Animus-Surge/stardragon-l3/README.md

# Stardragon

Stardragon is a tripoli L3 certification rocket based on an ultimate wildman rocket kit.

## Overview

## Quarto reports

Under `proposal_files` and `report_files`, there are the various reports that were generated for the proposal and final report.

## CAD files

## Simulations
