Animus-Surge/stardragon-l3/mission_patch.png

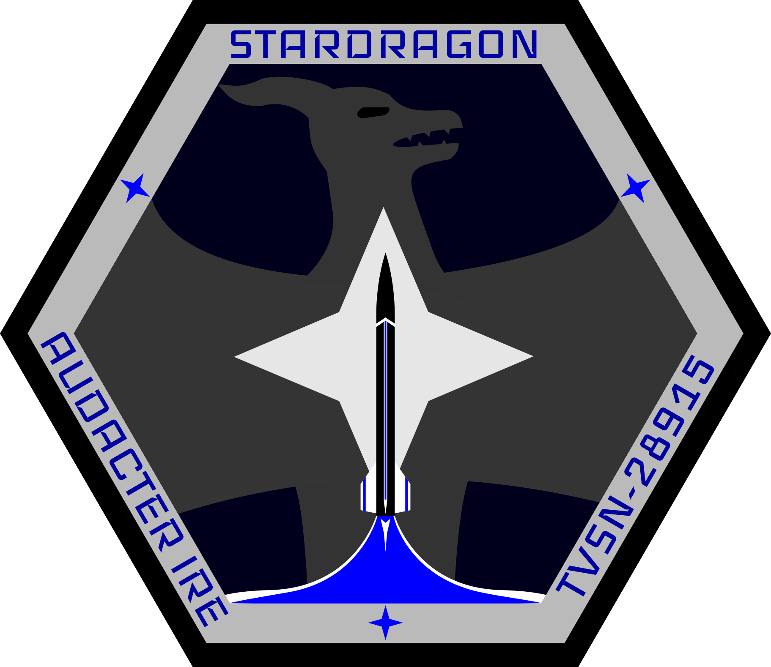
mission_patch.png
