Animus-Surge/stardragon-l3/proposal_files/flight_stage_diagram.drawio.png

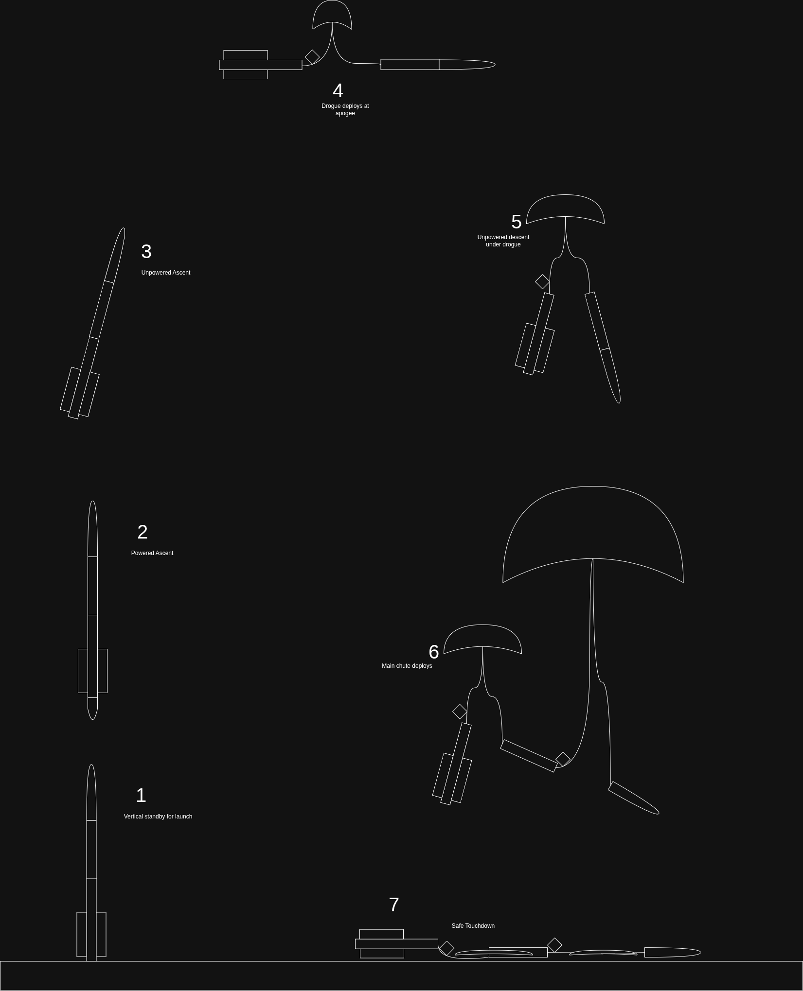
proposal_files/flight_stage_diagram.drawio.png
