Animus-Surge/stardragon-l3/proposal_files/skydragon_fursuit_resized.jpg

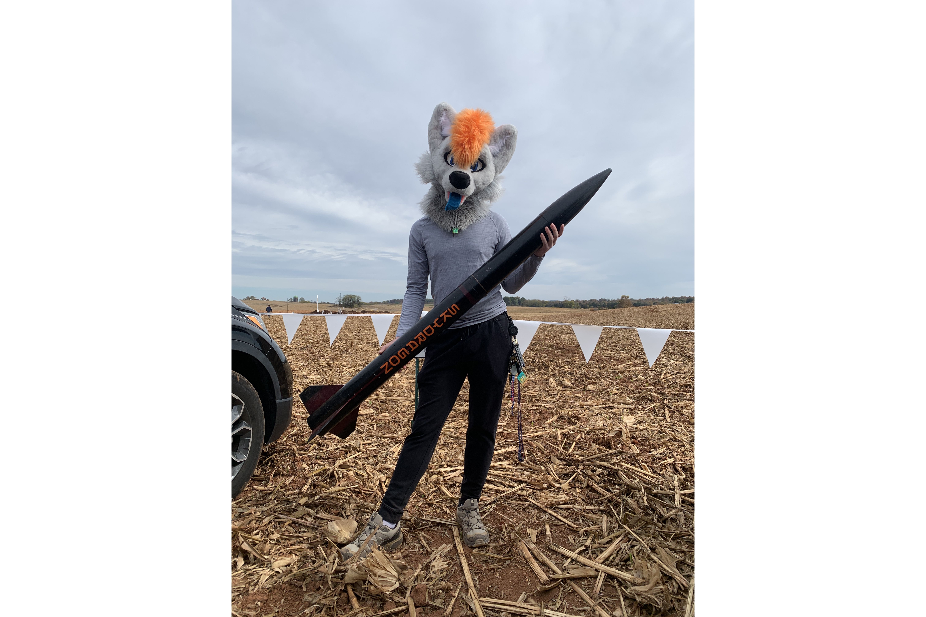
proposal_files/skydragon_fursuit_resized.jpg
