Animus-Surge/stardragon-l3/proposal_files/skydragon_pad.JPG

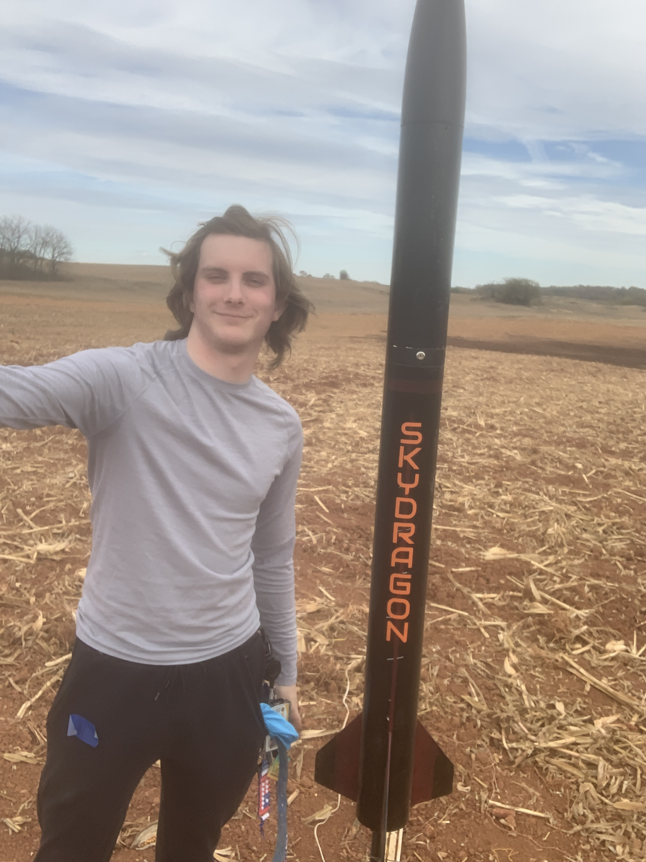
proposal_files/skydragon_pad.JPG
