Animus-Surge/stardragon-l3/order_tracker.ods

Stardragon Order Tracker
Name | Link | Qty | Price | Total Price | Order Date | Arrival Date | Notes
FCR6.0-4.0 Centering Ring | https://wildmanrocketry.com/collections/centering-ring-airframe/products/fcr6-0?variant=46733068042490 | 2 | $11.00 | $22.00 | 02/04/26 | 02/18/26
Rocketman 144” High Performance Parachute | https://www.the-rocketman.com/products/rocketman-high-performance-cd-2-2-parachutes?variant=42195940081758 | 1 | $395.00 | $395.00
Rocketman 24” High Performance Parachute | https://www.the-rocketman.com/products/rocketman-high-performance-cd-2-2-parachutes?variant=42195939754078 | 1 | $85.00 | $85.00
1/4-20 Stainless Steel Threaded Rod – 36” | https://www.mcmaster.com/98827A310/ | 1 | $18.12 | $18.12 | 02/17/26 | 02/17/26 | Got from Lowes
304 1” Stainless Steel U-Bolt | https://www.mcmaster.com/8896T103/ | 5 | $3.85 | $19.25 | 02/17/26 | 02/17/26 | Got from Lowes
304 1” Stainless Steel U-Bolt Bracket | https://www.mcmaster.com/8896T153/ | 10 | $2.13 | $21.30 | 02/17/26 | 02/17/26 | Got from Lowes
Bluejay 2+ | https://www.featherweightaltimeters.com/store/p28/Blue_Jay2_Altimeter.html | 1 | $104.00 | $104.00
Featherweight Tracker (Full System) | https://www.featherweightaltimeters.com/store/p22/Featherweight_GPS_Tracker_%28upd%29.html | 1 | $371.00 | $371.00
Quick Links | https://www.mcmaster.com/3711T24/ | 5 | $8.23 | $41.15
Pi Camera 3 | https://www.pishop.us/product/raspberry-pi-camera-module-3/ | 2 | $27.50 | $55.00
Raspberry Pi Zero 2 W | https://www.pishop.us/product/raspberry-pi-zero-2-w | 2 | $17.25 | $34.50
Max Bond 2 Part Epoxy | https://www.amazon.com/INDUSTRIAL-GRADE-Thixotropic-Epoxy-System/dp/B01J1ACH4G | 1 | $81.07 | $81.07 | 02/11/26
Key Switches | https://www.amazon.com/dp/B0BFGGK856 | 1 | $9.99 | $9.99 | 02/11/26
Charge wells | https://madcowrocketry.com/8g-removable-ejection-wells/ | 2 | $29.00 | $58.00
