Animus-Surge/stardragon-l3/(list of files, cad)

Other CAD files:
cad/stardragon_assembly.FCStd
avbay.FCStd
cad/avbay.FCStd
