Animus-Surge/stardragon-l3/avbay/stardragon_avbay.kicad_pcb

## KiCad design Pico-cular-Transportation/test/test.kicad_sch

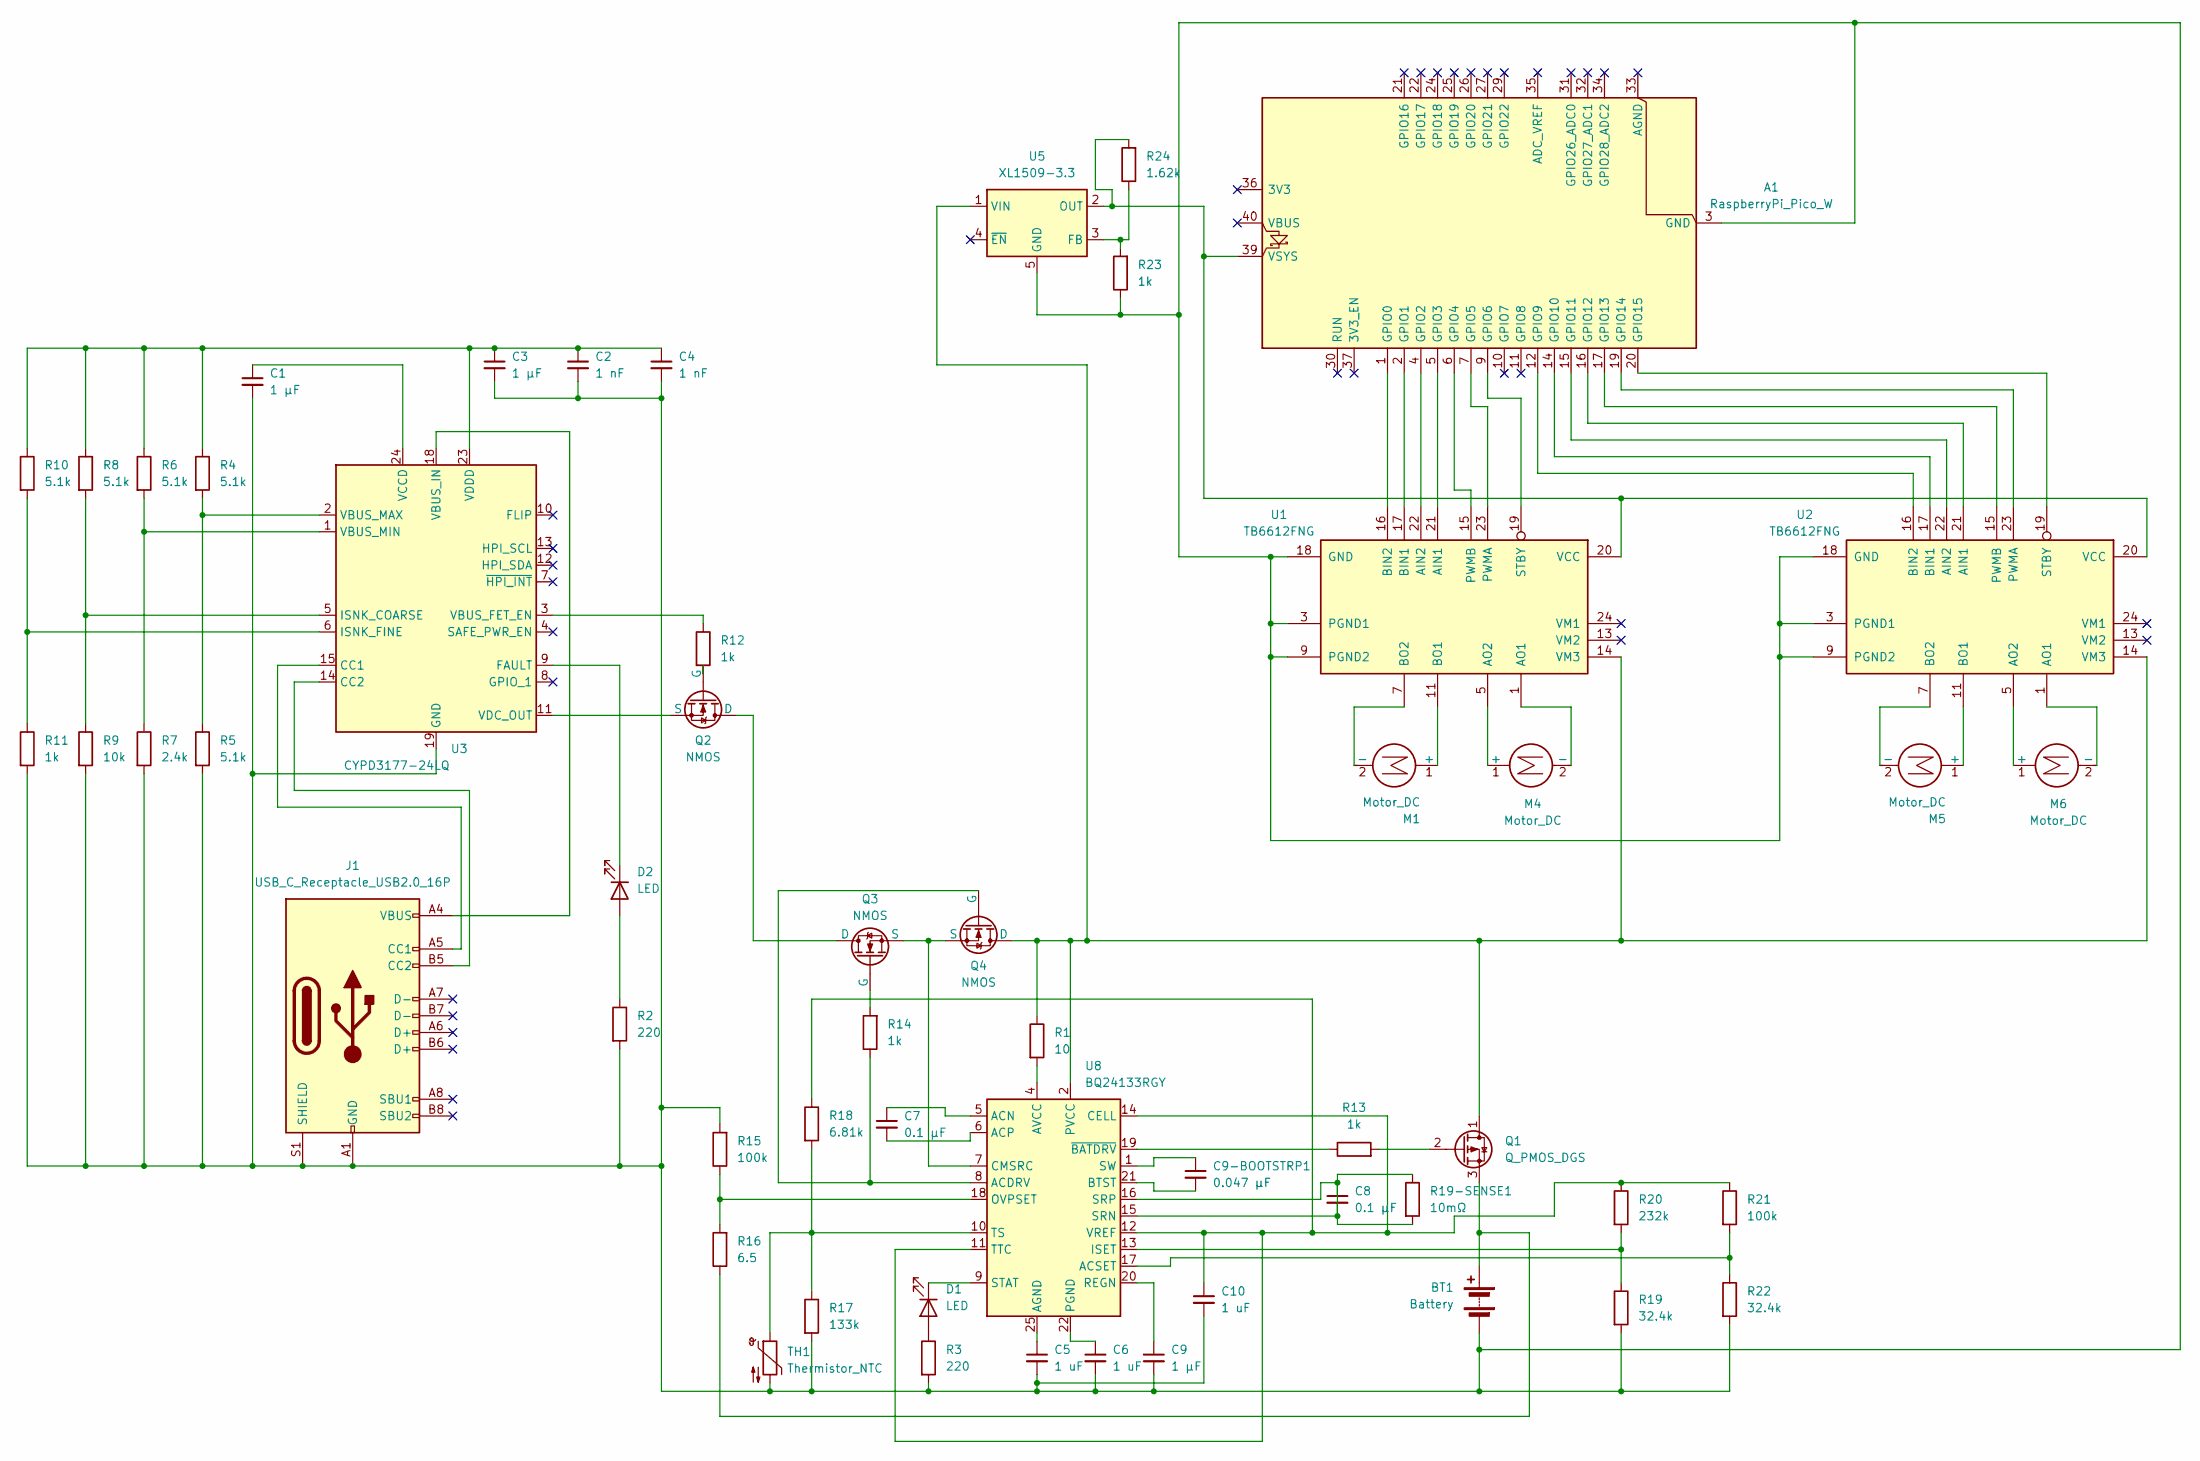
[picture p14: schematic test.kicad_sch]

Parts:
A1: RaspberryPi_Pico_W; RaspberryPi_Pico_Common_THT
BT1: Battery; BatteryHolder_TruPower_BH-331P_3xAA
C1, C3: 1 µF; CP_Elec_3x5.3
C2, C4: 1 nF; CP_Elec_3x5.3
C5, C6, C10: 1 uF; CP_Elec_3x5.3
C7, C8: 0.1 µF
C9: 1 µF
C9-BOOTSTRP1: 0.047 µF
D1, D2: LED; LED_D1.8mm_W1.8mm_H2.4mm_Horizontal_O1.27mm_Z1.6mm
J1: USB_C_Receptacle_USB2.0_16P; USB_C_Receptacle_Amphenol_12401548E4-2A
M1, M4, M5, M6: Motor_DC; Vybronics_VZ30C1T8219732L
Q1: Q_PMOS_DGS; SOT-23
Q2, Q3, Q4: NMOS; SOT-23
R1: 10; R_LDR_5.2x5.2mm_P3.5mm_Horizontal
R2, R3: 220; R_LDR_5.2x5.2mm_P3.5mm_Horizontal
R4, R5, R6, R8, R10: 5.1k; R_LDR_5.2x5.2mm_P3.5mm_Horizontal
R7: 2.4k; R_LDR_5.2x5.2mm_P3.5mm_Horizontal
R9: 10k; R_LDR_5.2x5.2mm_P3.5mm_Horizontal
R11, R12, R13, R14, R23: 1k; R_LDR_5.2x5.2mm_P3.5mm_Horizontal
R15, R21: 100k; R_LDR_5.2x5.2mm_P3.5mm_Horizontal
R16: 6.5; R_LDR_5.2x5.2mm_P3.5mm_Horizontal
R17: 133k; R_LDR_5.2x5.2mm_P3.5mm_Horizontal
R18: 6.81k; R_LDR_5.2x5.2mm_P3.5mm_Horizontal
R19, R22: 32.4k; R_LDR_5.2x5.2mm_P3.5mm_Horizontal
R19-SENSE1: 10mΩ
R20: 232k; R_LDR_5.2x5.2mm_P3.5mm_Horizontal
R24: 1.62k; R_LDR_5.2x5.2mm_P3.5mm_Horizontal
TH1: Thermistor_NTC
U1, U2: TB6612FNG; SSOP-24_5.3x8.2mm_P0.65mm
U3: CYPD3177-24LQ; QFN-24-1EP_4x4mm_P0.5mm_EP2.75x2.75mm
U5: XL1509-3.3; SOIC-8_3.9x4.9mm_P1.27mm
U8: BQ24133RGY; Texas_RGY_R-PVQFN-N24_EP2.05x3.1mm

Connections:
unnamed: A1.1 (GPIO0), U1.16 (BIN2)
unnamed: A1.2 (GPIO1), U1.17 (BIN1)
unnamed: A1.4 (GPIO2), U1.22 (AIN2)
unnamed: A1.5 (GPIO3), U1.21 (AIN1)
unnamed: A1.6 (GPIO4), U1.15 (PWMB)
unnamed: A1.7 (GPIO5), U1.23 (PWMA)
unnamed: A1.9 (GPIO6), U1.19 (STBY)
unnamed: A1.12 (GPIO9), U2.16 (BIN2)
unnamed: A1.3 (GND), A1.8 (GND), A1.13 (GND), A1.18 (GND), A1.23 (GND), A1.28 (GND), A1.38 (GND), BT1.2 (-), C1.2, C2.2, C3.2, C4.2, C5.2, C6.2, C9.2, C10.2, J1.A1 (GND), J1.A12 (GND), J1.B1 (GND), J1.B12 (GND), J1.S1 (SHIELD), R2.2, R3.2, R5.2, R7.2, R9.2, R11.2, R15.2, R17.2, R19.2, R22.2, R23.1, TH1.2, U1.3 (PGND1), U1.4 (PGND1), U1.9 (PGND2), U1.10 (PGND2), U1.18 (GND), U2.3 (PGND1), U2.4 (PGND1), U2.9 (PGND2), U2.10 (PGND2), U2.18 (GND), U3.19 (GND), U3.22 (GND), U3.25 (GND), U5.5 (GND), U5.6 (GND), U5.7 (GND), U5.8 (GND)
unnamed: A1.14 (GPIO10), U2.17 (BIN1)
unnamed: A1.15 (GPIO11), U2.22 (AIN2)
unnamed: A1.16 (GPIO12), U2.21 (AIN1)
unnamed: A1.17 (GPIO13), U2.15 (PWMB)
unnamed: A1.19 (GPIO14), U2.23 (PWMA)
unnamed: A1.20 (GPIO15), U2.19 (STBY)
unnamed: A1.39 (VSYS), R24.2, U1.20 (VCC), U2.20 (VCC), U5.2 (OUT)
unnamed: BT1.1 (+), Q1.3 (S), R16.1
unnamed: C1.1, U3.24 (VCCD)
unnamed: C2.1, C3.1, C4.1, R4.1, R6.1, R8.1, R10.1, U3.23 (VDDD)
unnamed: C5.1, U8.25 (AGND)
unnamed: C6.1, U8.22 (PGND), U8.23 (PGND)
unnamed: C7.1, U8.5 (ACN)
unnamed: C7.2, U8.6 (ACP)
unnamed: C8.1, C8.2, R19-SENSE1.1, R19-SENSE1.2, U8.15 (SRN), U8.16 (SRP)
unnamed: C9-BOOTSTRP1.1, U8.1 (SW), U8.24 (SW)
unnamed: C9-BOOTSTRP1.2, U8.21 (BTST)
unnamed: C9.1, U8.20 (REGN)
unnamed: C10.1, R18.1, R20.1, R21.1, U8.11 (TTC), U8.12 (VREF), U8.14 (CELL)
unnamed: D1.1 (K), U8.9 (STAT)
unnamed: D1.2 (A), R3.1
unnamed: D2.1 (K), U3.9 (FAULT)
unnamed: D2.2 (A), R2.1
unnamed: J1.A4 (VBUS), J1.A9 (VBUS), J1.B4 (VBUS), J1.B9 (VBUS), U3.18 (VBUS_IN)
unnamed: J1.A5 (CC1), U3.15 (CC1)
unnamed: J1.B5 (CC2), U3.14 (CC2)
unnamed: M1.1 (+), U1.11 (BO1), U1.12 (BO1)
unnamed: M1.2 (-), U1.7 (BO2), U1.8 (BO2)
unnamed: M4.1 (+), U1.5 (AO2), U1.6 (AO2)
unnamed: M4.2 (-), U1.1 (AO1), U1.2 (AO1)
unnamed: M5.1 (+), U2.11 (BO1), U2.12 (BO1)
unnamed: M5.2 (-), U2.7 (BO2), U2.8 (BO2)
unnamed: M6.1 (+), U2.5 (AO2), U2.6 (AO2)
unnamed: M6.2 (-), U2.1 (AO1), U2.2 (AO1)
unnamed: Q1.1 (D), Q4.1 (D), R1.1, U1.14 (VM3), U2.14 (VM3), U5.1 (VIN), U8.2 (PVCC), U8.3 (PVCC)
unnamed: Q1.2 (G), R13.2
unnamed: Q2.1 (D), Q3.1 (D)
unnamed: Q2.2 (G), R12.2
unnamed: Q2.3 (S), U3.11 (VDC_OUT)
unnamed: Q3.2 (G), R14.2
unnamed: Q3.3 (S), Q4.3 (S), U8.7 (CMSRC)
unnamed: Q4.2 (G), R14.1, U8.8 (ACDRV)
unnamed: R1.2, U8.4 (AVCC)
unnamed: R4.2, R5.1, U3.2 (VBUS_MAX)
unnamed: R6.2, R7.1, U3.1 (VBUS_MIN)
unnamed: R8.2, R9.1, U3.5 (ISNK_COARSE)
unnamed: R10.2, R11.1, U3.6 (ISNK_FINE)
unnamed: R12.1, U3.3 (VBUS_FET_EN)
unnamed: R13.1, U8.19 (~BATDRV)
unnamed: R15.1, R16.2, U8.18 (OVPSET)
unnamed: R17.1, R18.2, TH1.1, U8.10 (TS)
unnamed: R19.1, R20.2, U8.13 (ISET)
unnamed: R21.2, R22.1, U8.17 (ACSET)
unnamed: R23.2, R24.1, U5.3 (FB)
