Animus-Surge/stardragon-l3/(commit log)

2026-02-10 Add project files, sims, freecad models, and openrocket
    [avbay.FCStd, stardragon_assembly.FCStd]
2026-02-25 Backups; add order tracker, mission patch, av bay designs
    [avbay.FCStd, order_tracker.ods, stardragon_avbay.kicad_pcb, stardragon_avbay.kicad_sch]
