Animus-Surge/stardragon-l3/proposal_files/skydragon_fursuit.JPG

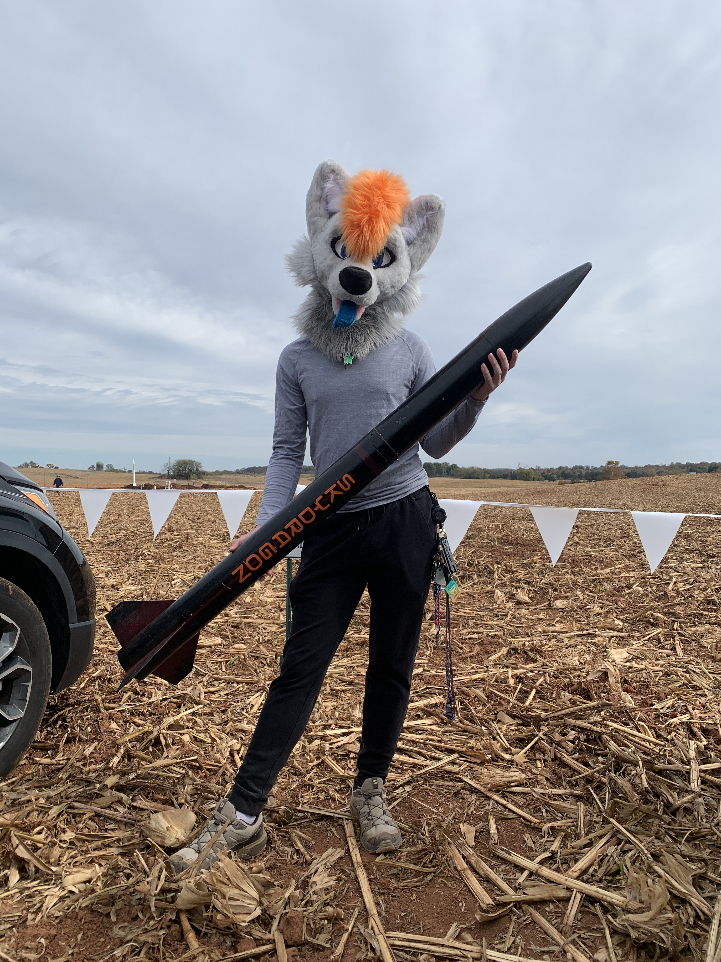
proposal_files/skydragon_fursuit.JPG
